ReinventONE/occupus/images/module-display/DisplayUnit-1.jpg

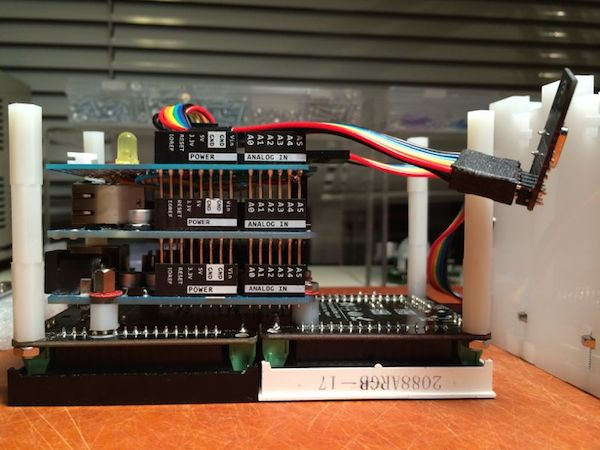
images/module-display/DisplayUnit-1.jpg
