ReinventONE/occupus/images/module-display/DisplayUnit-2.jpg

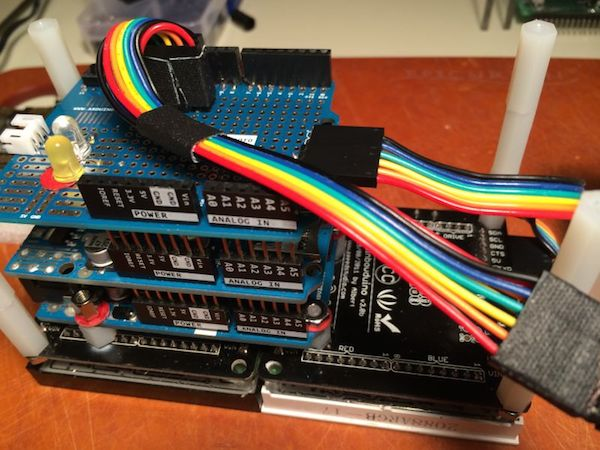
images/module-display/DisplayUnit-2.jpg
