ReinventONE/occupus/images/module-display/DisplayUnit-3.jpg

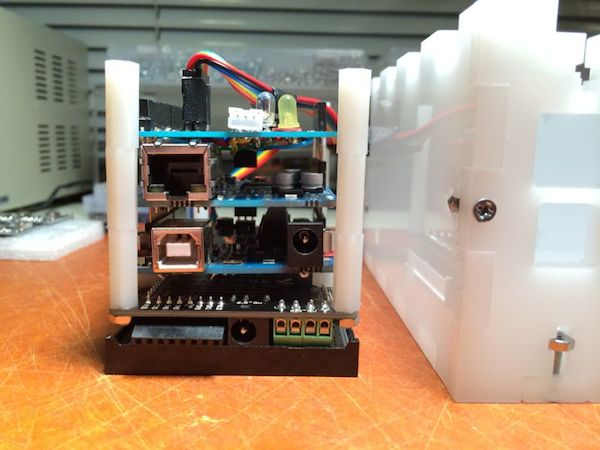
images/module-display/DisplayUnit-3.jpg
