ReinventONE/occupus/images/module-display/DisplayUnit-4.jpg

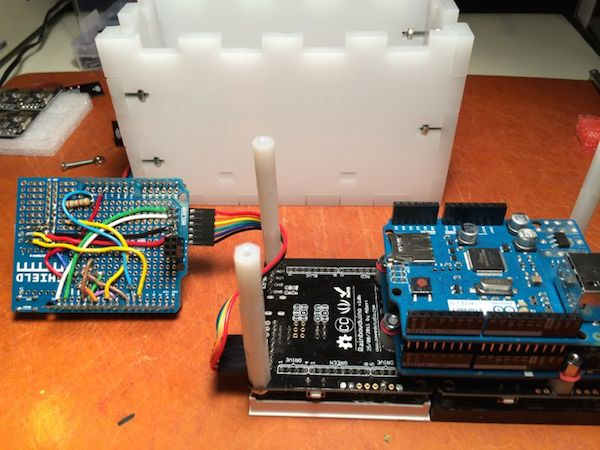
images/module-display/DisplayUnit-4.jpg
