ReinventONE/occupus/images/module-display/DisplayUnit-5.jpg

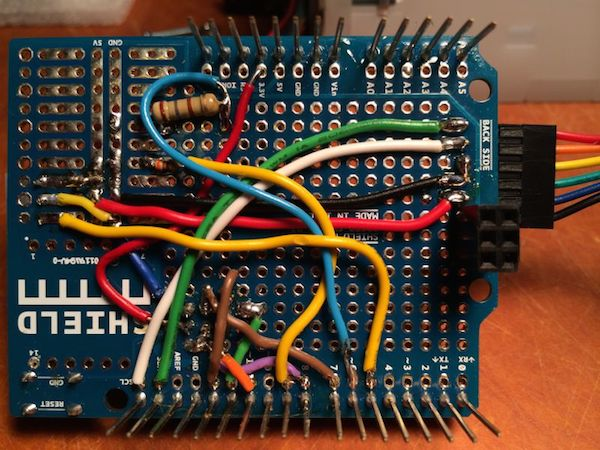
images/module-display/DisplayUnit-5.jpg
