ReinventONE/occupus/images/module-display/DisplayUnit-6.jpg

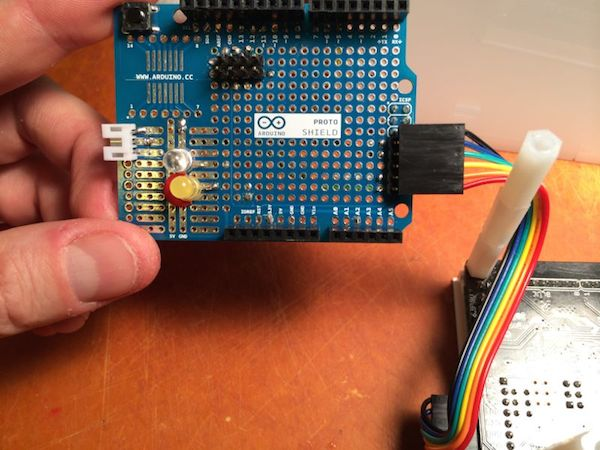
images/module-display/DisplayUnit-6.jpg
