ReinventONE/occupus/images/module-observer/Observer-EarlyPrototype.jpg

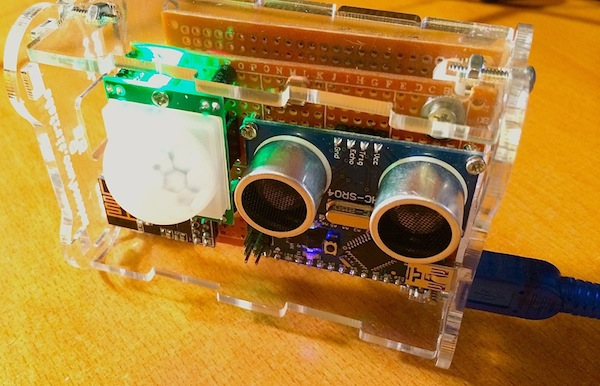
images/module-observer/Observer-EarlyPrototype.jpg
