ReinventONE/occupus/images/module-observer/Observer-Final-Nano-Shield.jpg

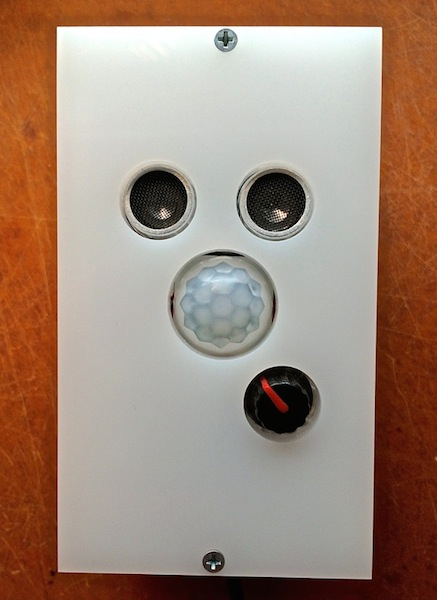
images/module-observer/Observer-Final-Nano-Shield.jpg
