ReinventONE/occupus/images/module-observer/Observer-Final-SinglePCB-HandMade.jpg

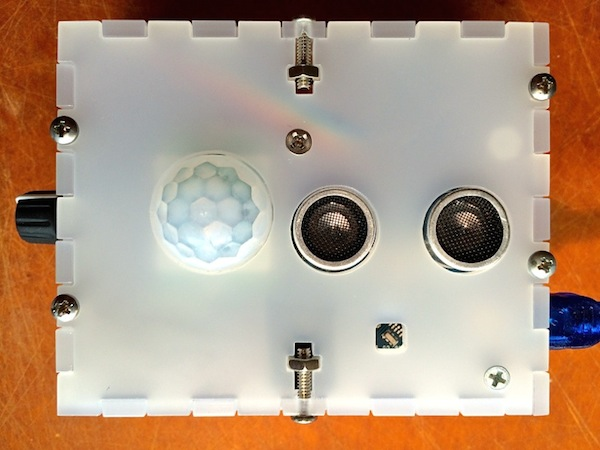
images/module-observer/Observer-Final-SinglePCB-HandMade.jpg
