ReinventONE/occupus/images/module-observer/Observer-Module-3-Front.jpg

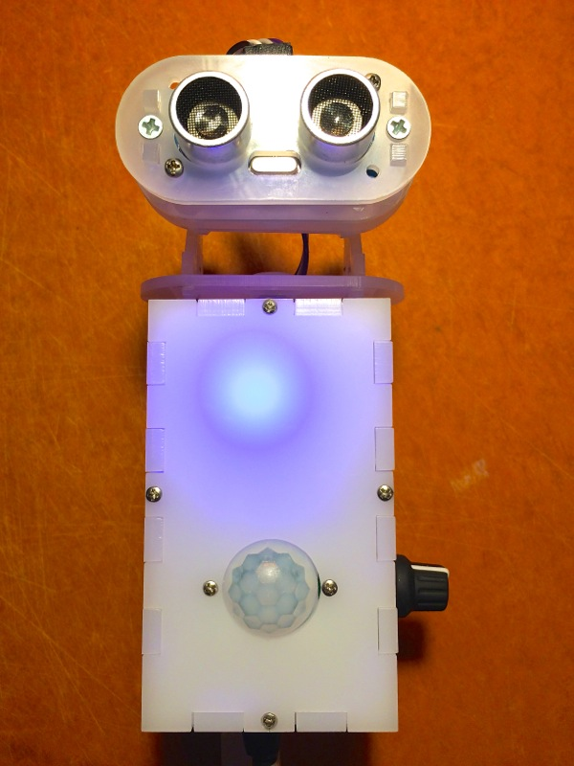
images/module-observer/Observer-Module-3-Front.jpg
