ReinventONE/occupus/images/module-observer/Observer-Module-3-Side.jpg

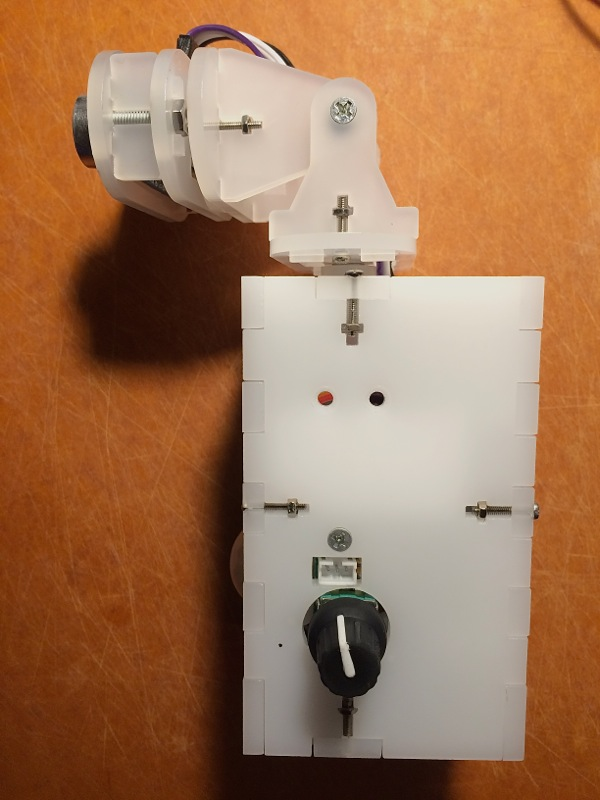
images/module-observer/Observer-Module-3-Side.jpg
