ReinventONE/occupus/images/module-observer/Observer-Module-3.jpg

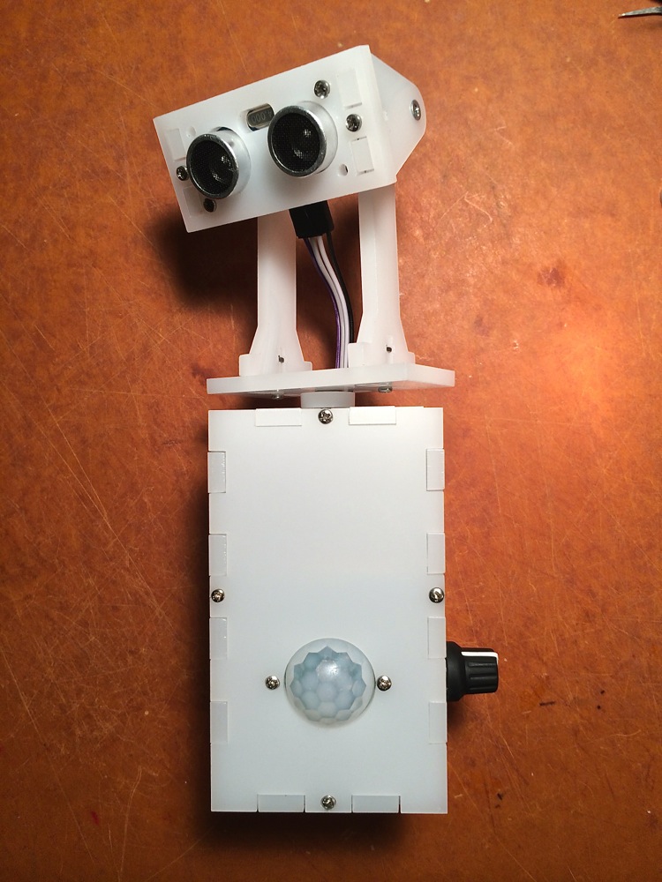
images/module-observer/Observer-Module-3.jpg
