ReinventONE/occupus/images/module-observer/Observer-WoodenPanel-Prototype.jpg

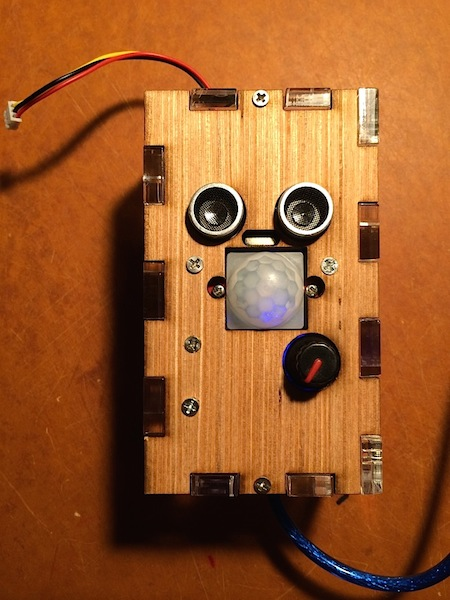
images/module-observer/Observer-WoodenPanel-Prototype.jpg
