ReinventONE/occupus/images/real-life-examples/borat-at-wanelo.jpg

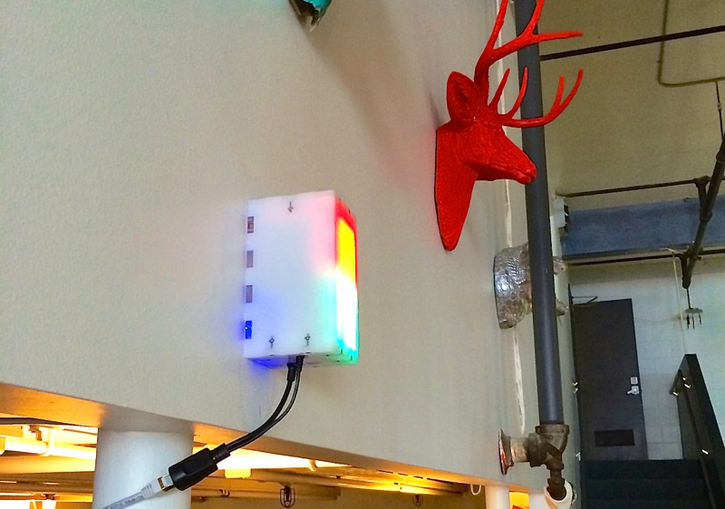
images/real-life-examples/borat-at-wanelo.jpg
