ReinventONE/occupus/firmware/Display/rf24_receive.ino

/*
 * This code is based on the example by
 Copyright (C) 2011 J. Coliz <maniacbug@ymail.com>
 */

/*
 * Connections:
 *
 GND		GND
 3V3		3V3
 CE		9
 CSN		10
 SCK		13
 MOSI	11
 MISO	12

 */

#include <SPI.h>
#include "nRF24L01.h"
#include "RF24.h"
#include "printf.h"
#include <SimpleTimer.h>

#define INACTIVITY_TIMEOUT 5000
//
// Hardware configuration
//

// Set up nRF24L01 radio on SPI bus plus pins 9 & 10

RF24 radio(9, 10);
SimpleTimer timer(1);
typedef struct publisherInfoStruct {
	uint8_t led;
	bool status;
	bool connected;
	uint64_t pipe;
	uint8_t senderId;
	unsigned long lastTransmissionAt;
} publisherInfo;

publisherInfo publisher[] = {
		{ 7, false, false, 0xF0F0F0F0E1LL, 0x010, 0 },
		{ 8, false, false, 0xF0F0F0F0D2LL, 0x020, 0 }
};

static const uint8_t transmitters = sizeof(publisher) / sizeof(publisherInfo);

void showStatus(int timerId) {
	for (int i = 0; i < transmitters; i++) {
		digitalWrite(publisher[i].led, publisher[i].status ? HIGH : LOW);
		printf("transmitter %d is %7s, status = %3s\n", i+1,
				publisher[i].connected? "online" : "offline",
				publisher[i].status ? "ON" : "OFF");
	}
	printf("\n");
}

void resetDeadRadios(int timerId) {
	for (int i = 0; i < transmitters; i++) {
		if (millis() - publisher[i].lastTransmissionAt > INACTIVITY_TIMEOUT
				&& publisher[i].status) {
			printf("resetting dead radio %d: last heard %d seconds ago\n",
					i+1,
					(int)((millis() - publisher[i].lastTransmissionAt) / 1000));
			publisher[i].status = false;
			publisher[i].connected = false;
		}
	}
}

void setup(void) {
	Serial.begin(57600);

	printf_begin();
	printf("\n\rRF24: receive module!\n\n");

	radio.begin();
	// optionally, increase the delay between retries & # of retries
	radio.setRetries(15, 15);

	// optionally, reduce the payload size.  seems to improve reliability
	radio.setPayloadSize(8);

	radio.openReadingPipe(1, publisher[0].pipe);
	radio.openReadingPipe(2, publisher[1].pipe);

	radio.startListening();
	radio.printDetails();

	for (int i = 0; i < transmitters; i++) {
		pinMode(publisher[i].led, OUTPUT);
	}

	timer.setInterval(2000, &resetDeadRadios);
	timer.setInterval(990,  &showStatus);
}
void loop(void) {

	// if there is data ready
	if (radio.available()) {
		unsigned long data = 0;
		bool done = false;
		while (!done) {
			// Fetch the payload, and see if this was the last one.
			done = radio.read(&data, sizeof(data));
			// printf("got data [%d]\n", data);
			for (int i = 0; i < transmitters; i++) {
				if ((data & publisher[i].senderId) == publisher[i].senderId) {
					publisher[i].connected = true;
					publisher[i].status = data & 1;
					publisher[i].lastTransmissionAt = millis();
					// printf("status for %d is %d", i, publisher[i].status);
				}
			}
			timer.run();
		}
	}
	timer.run();
}
