ReinventONE/occupus/firmware/Observer/Modular.h

/*
 * Modular.h
 *
 *  Created on: Sep 1, 2014
 *      Author: Konstantin Gredeskoul
 *
 *  (c) 2014 All rights reserved.  Please see LICENSE.
 */

#ifndef MODULAR_H_
#define MODULAR_H_

/*
 * Uncomment only ONE of the below defines.
 */
//#define SENDER_DOWNSTAIRS
//#define SENDER_UPSTAIRS
#define SENDER_THIRDBOX

#endif /* MODULAR_H_ */
