ReinventONE/occupus/(commit log)

2014-08-08 Working version with 3 sensors
2014-08-09 Working prototype with all pieces together.
2014-08-10 Major refactor, and switching to timers everywhere
2014-08-13 Fixing a bunch of issues
    [Display.ino, Observer.ino]
2014-08-20 Adding ability to invert light sensor readings
    - if it was wired incorrectly (like I did) high
    values would mean dark, low would mean light.
2014-08-20 Blink red error when can not connect to Display
    [Observer.ino]
2014-08-25 Removing inverted option – gotta solder right:)
2014-08-25 Configuration calibration time
2014-08-25 Configure threshold and get distance from Sonar
2014-08-25 New Configuration object + LCD Serial Output
    [Configuration.h]
2014-08-25 Read/Write configuration into EEPROM, like a boss.
    - also add callbacks for changing configuration so that
    new values can be shown somewhere
    - switch grace period to seconds
    - use F() macros where possible to save RAM
    - remove links to SimpleNetwork lib
    - Add EEPROMEx library
    [Configuration.h]
2014-08-29 Changing frequency of LEDs and analyze
2014-08-30 Adding LCD display to Display unit
    [Configuration.h]
2014-09-04 Adding more robustness into wireless connectivity
    - some observer units would go into an infinite
    red blinking state and not be able to connect,
    even though the display is available and is able
    to see the client.
    Doing explicit calls to ```PowerDown``` etc make
    such cases recoverable.
2014-09-11 Updating Project with dependencies to libs outside
    - Moved a bunch of reusable libraries to
    git@github.com:kigster/Kiguino.git
    - Now Sensor wrappers can be used by other projects
2014-09-24 Broken branch
    [Configuration.h]
2014-09-25 Adding several usability features:
    - can choose not to save settings
    - can enable/disable RADIO to tweak settings
    - ran into memory overload problem, so running very close.
    [Configuration.h]
